cometcannon/tshirt-cannon-robot/doc/tikz-figures/kinematics.tex

\documentclass{standalone}
\usepackage{tikz}
\usepackage{standalone}

\newcommand{\AxisRotator}[1][rotate=0]{\tikz [x=0.25cm,y=0.60cm,line width=.2ex,-stealth,#1] \draw (0,0) arc (-150:150:1 and 1);}

\begin{document}
  \tikzstyle{robot} = [rectangle, minimum width=3cm, minimum height=4cm,text centered, draw=black]
  \tikzstyle{wheel} = [rectangle, minimum width=5mm, minimum height=1cm, draw=black]
  \tikzstyle{arrow} = [thick, ->, >=latex]
  \tikzstyle{dist} = [thick, <->, >=|]

  \begin{tikzpicture}
    \node (robot) [robot] {};
    \node (wheel 1) [wheel, left of=robot, xshift=-7.5mm, yshift=1cm] {0};
    \node (wheel 2) [wheel, right of=robot, xshift=7.5mm, yshift=1cm] {1};
    \node (wheel 3) [wheel, right of=robot, xshift=7.5mm, yshift=-1cm] {2};
    \node (wheel 4) [wheel, left of=robot, xshift=-7.5mm, yshift=-1cm] {3};

    \draw [arrow] (0,0) -- node[anchor=north, xshift=-4mm] {y} (-1,0);
    \draw [arrow] (0,0) -- node[anchor=west, yshift=5mm] {x} (0,1);
    \draw (0,0)  -- (0,0) node[xshift=2.8mm] {\AxisRotator[x=0.3cm,y=0.3cm,->,rotate=-90,black] $\omega_z$};
    \draw [dist] (0,2.3) -- node[anchor=south] {$l_1$} (1.8,2.3);
    \draw [dist] (0.03,2.3) -- node[anchor=south] {$l_1$} (-1.8,2.3);
    \draw [dist] (0,-2.3) -- node[anchor=north] {$l_1$} (1.8,-2.3);
    \draw [dist] (0.03,-2.3) -- node[anchor=north] {$l_1$} (-1.8,-2.3);
    \draw [dist] (2.3,0) -- node[anchor=west] {$l_2$} (2.3, 1);
    \draw [dist] (2.3,0.03) -- node[anchor=west] {$l_2$} (2.3, -1);
    \draw [dist] (-2.3,0) -- node[anchor=east] {$l_2$} (-2.3, 1);
    \draw [dist] (-2.3,0.03) -- node[anchor=east] {$l_2$} (-2.3, -1);
  \end{tikzpicture}
\end{document}
