cometcannon/tshirt-cannon-robot/doc/pics/wbs.pdf

5/9/2015 | Teleoperated Mobile Garment Accelerator
http://publish.smartsheet.com/b43ca22360854cf6b6d9cb59e5b9d781 | 1/2

## Teleoperated Mobile Garment Accelerator

| Tasks | Assigned to | Start | Finish
1 | Chassis
2 | Research chassis design | Hazen Eckert | 09/23/14 | 10/07/14
3 | Research suppliers and pricing | Hazen Eckert | 09/23/14 | 10/07/14
4 | Research mount designs | Omar Hasan | 09/23/14 | 10/07/14
5 | Chassis assembly | Omar Hasan | 11/05/14 | 11/15/14
6 | Chassis testing | Ryan Marcotte | 11/19/14 | 11/20/14
7 | Building mount | Ridhwaan Rahman | 02/06/15 | 03/31/15
8 | T shirt cannon
9 | Research solenoids | Hazen Eckert | 10/29/14 | 11/07/14
10 | Research tshirt cannons | Ridhwaan Rahman | 09/23/14 | 10/07/14
11 | Cannon testing | Hazen Eckert | 11/05/14 | 11/06/14
12 | Kill switch | Hazen Eckert | 11/11/14 | 12/12/14
13 | Cannon remote triggering | Hazen Eckert | 01/23/15 | 01/25/14
14 | Pneumatics | Hazen Eckert | 11/11/14 | 12/12/14
15 | Choosing a Hose | Hazen Eckert | 03/12/15 | 03/14/15
16 | Filling CO2 tank | Ridhwaan Rahman | 01/30/15 | 05/01/15
17 | Testing Electronic Charging/Firing | Hazen Eckert | 03/05/15 | 03/08/15
18 | Barrel support | Ridhwaan Rahman | 03/05/15 | 03/15/14
19 | Control Electronics
20 | Code for controlling wheels | Omar Hasan | 10/22/14 | 10/29/14
21 | Research on microcontrollers | Ryan Marcotte | 09/23/14 | 10/07/14
22 | Testing encoders/speed controllers | Omar Hasan | 11/19/14 | 02/03/15
23 | Implementing magic bytes | Omar Hasan | 02/13/15 | 02/20/15
24 | Power Distribution
25 | Procure battery | Omar Hasan | 10/22/14 | 10/29/14
26 | Research batteries, speed controllers | Omar Hasan | 09/23/14 | 10/15/14
27 | Research power conversion | Hazen Eckert | 10/22/14 | 10/29/14
28 | Power regulation, electronic triggering | Hazen Eckert | 02/13/15 | 03/13/15
29 | Wiring | Hazen Eckert | 02/27/15 | 03/05/15
30 | Protoboard | Hazen Eckert | 04/09/15 | 04/23/15
31 | User Interface
32 | Research camera | Ryan Marcotte | 10/22/14 | 10/29/14
33 | Research on networking | Ryan Marcotte | 09/23/14 | 10/07/14
34 | Set up build environment for Yun | Ryan Marcotte | 10/22/14 | 02/04/15
35 | Research camera streaming | Ridhwaan Rahman | 10/29/14 | 11/05/14
36 | Documentation/software planning | Ryan Marcotte | 11/05/14 | 04/23/15
37 | Video streaming | Ridhwaan Rahman | 11/05/14 | 11/19/14
38 | Writing Xbox controller module | Ryan Marcotte | 02/27/15 | 03/06/15

5/9/2015 | Teleoperated Mobile Garment Accelerator
http://publish.smartsheet.com/b43ca22360854cf6b6d9cb59e5b9d781 | 2/2

Collaboration (http://www.smartsheet.com/product-tour/collaboration?s=155) powered by Smartsheet

39 | Remote Control Feature | Ryan Marcotte | 03/12/15 | 03/19/15
40 | GUI | Ryan Marcotte | 04/23/15 | 04/27/15
41 | Miscellaneous
42 | Ethics Report | Ridhwaan Rahman | 10/22/14 | 10/24/14
43 | Learning git | Ridhwaan Rahman | 10/29/14 | 01/23/15
44 | Poster | Ridhwaan Rahman | 11/19/14 | 11/26/14
45 | Debugging Atheros boot sequence | Omar Hasan | 02/19/15 | 02/26/15
46 | Debugging Atheros to AVR serial connection | Ryan Marcotte | 02/19/15 | 02/26/15
47 | Ethics Report | Ridhwaan Rahman | 03/12/15 | 03/19/15
48 | Max speed testing | Ryan Marcotte | 04/09/15 | 04/11/15
49 | Max speed testing | Omar Hasan | 04/09/15 | 04/11/15
