cometcannon/tshirt-cannon-robot/doc/pics/electronics/protoboard.jpg

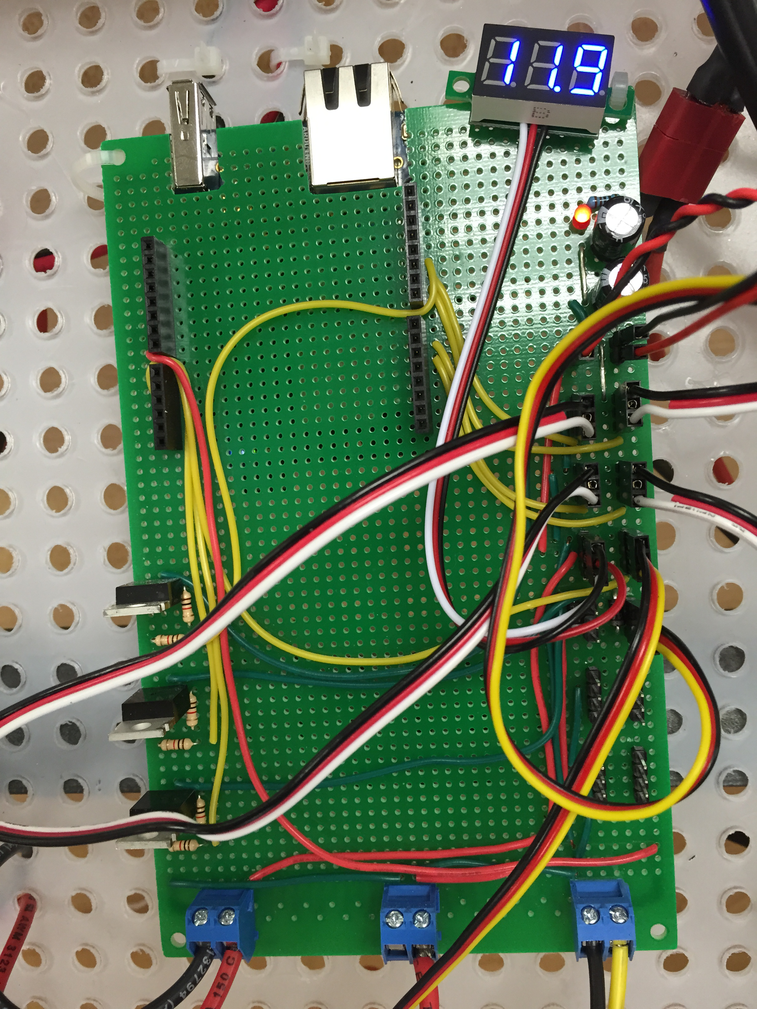
doc/pics/electronics/protoboard.jpg
