cometcannon/tshirt-cannon-robot/doc/pics/s1.pdf

# Teleoperated Mobile Garment Accelerator

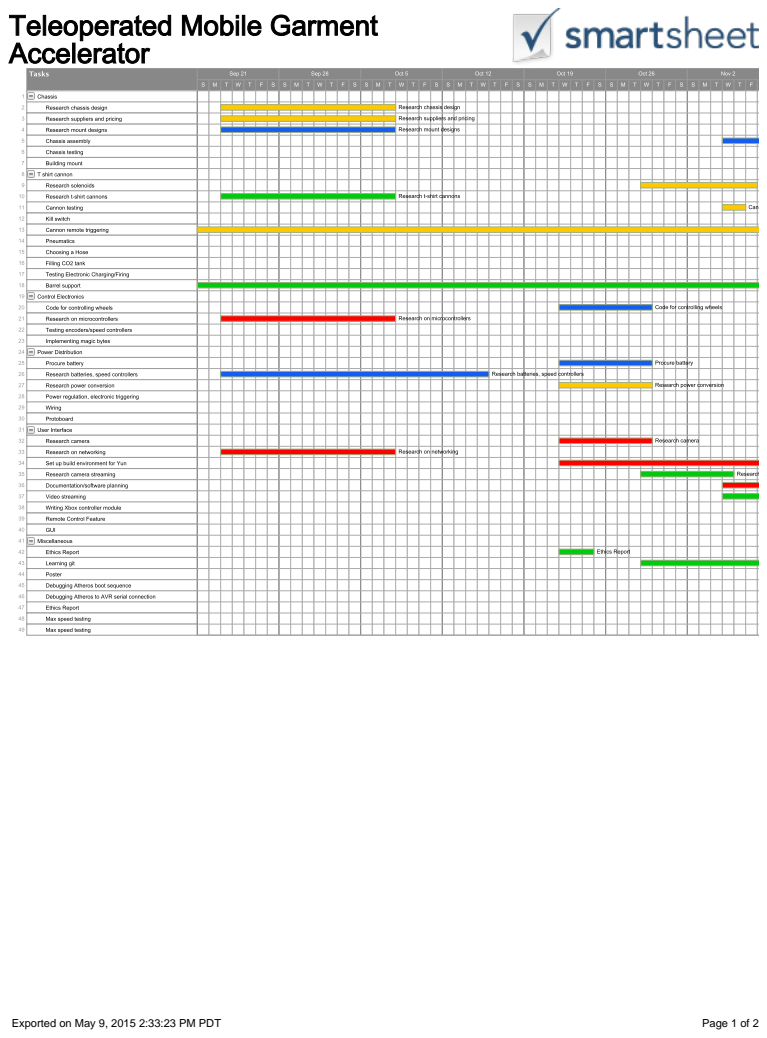
[picture p9: page 1]
Exported on May 9, 2015 2:33:23 PM PDT; Page 1 of

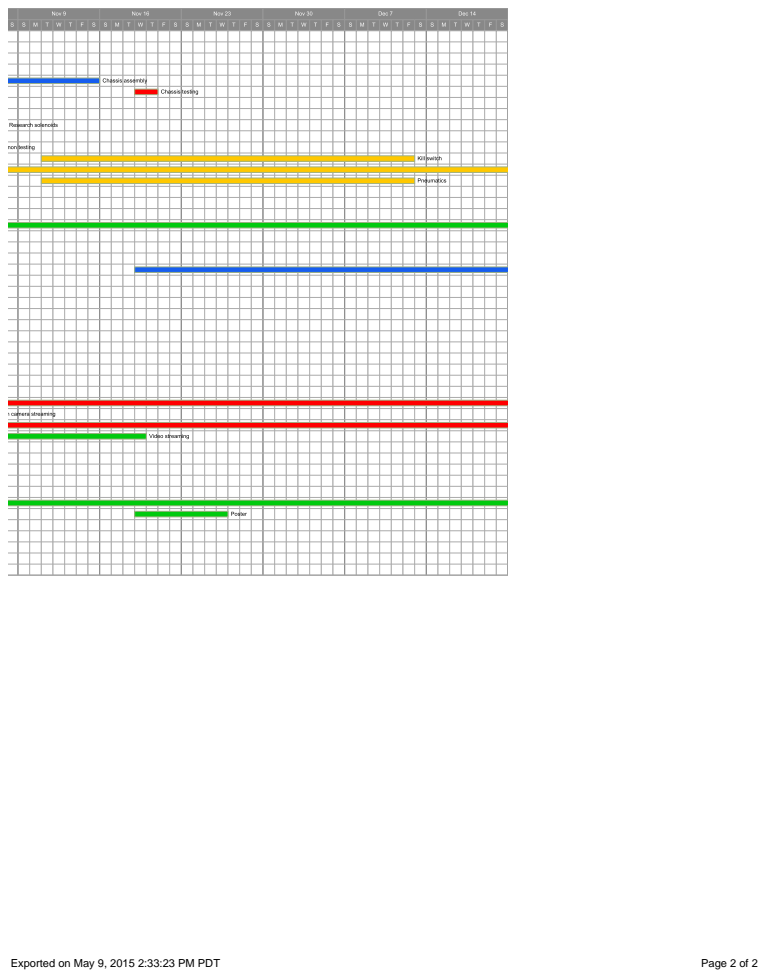
[picture p10: page 2]
Exported on May 9, 2015 2:33:23 PM PDT; Page 2 of
