cometcannon/tshirt-cannon-robot/doc/pics/s2.pdf

# Teleoperated Mobile Garment Accelerator

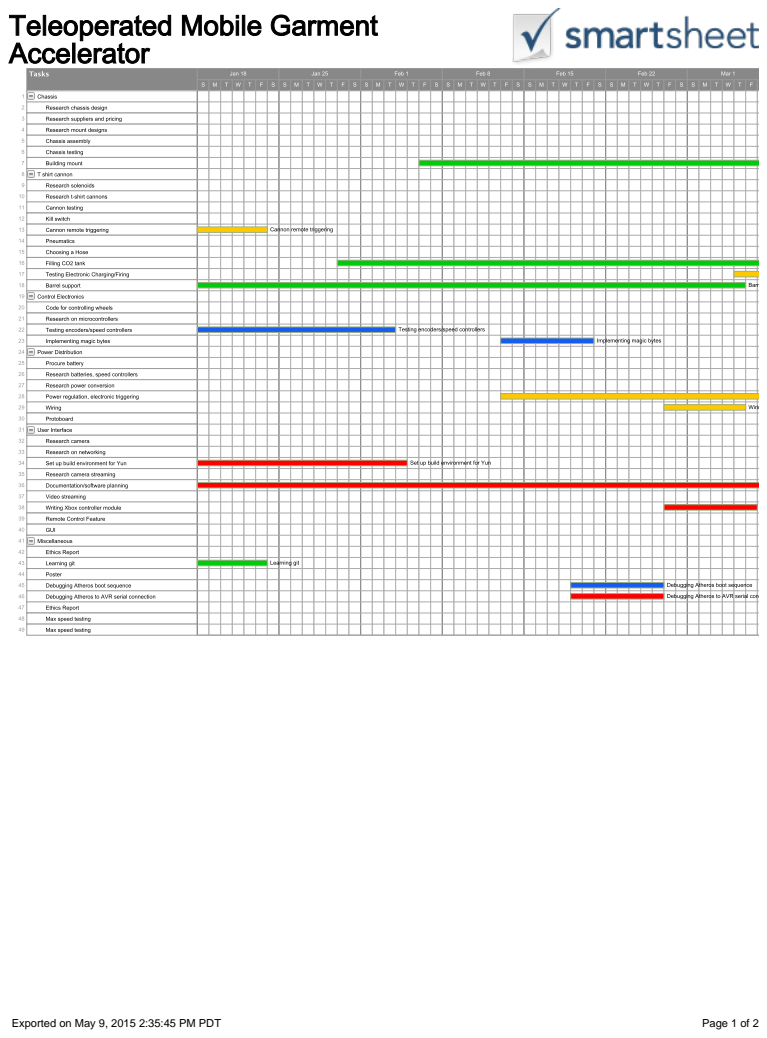
[picture p11: page 1]
Exported on May 9, 2015 2:35:45 PM PDT; Page 1 of

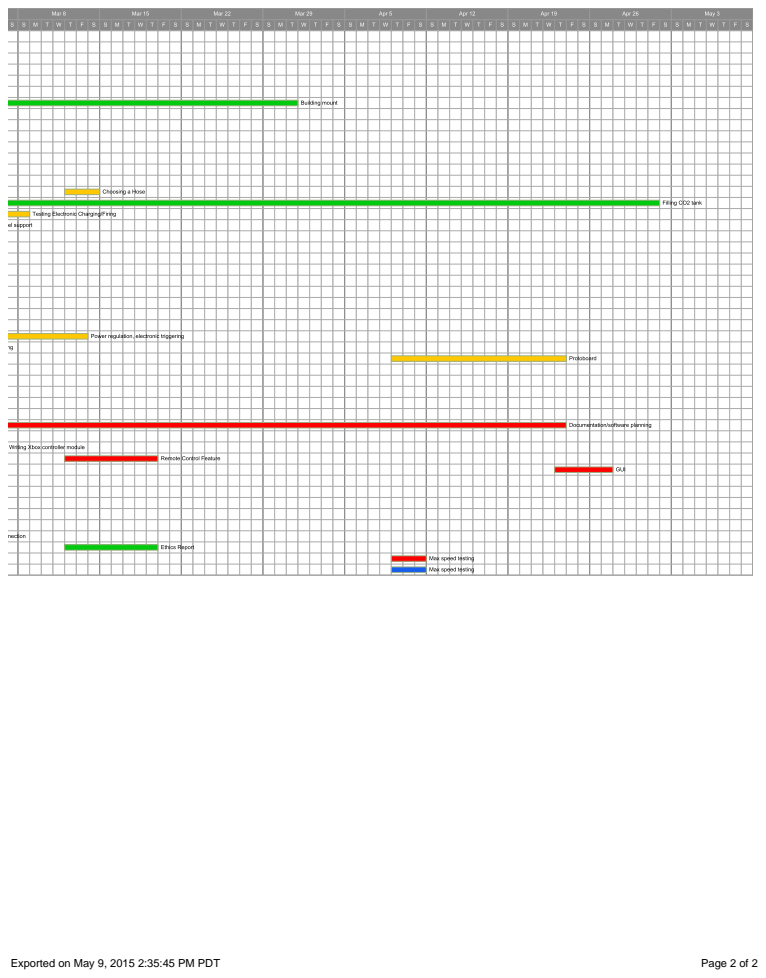
[picture p12: page 2]
Exported on May 9, 2015 2:35:45 PM PDT; Page 2 of
