cometcannon/tshirt-cannon-robot/src/AVR/test/wheel_test/wheel.h

#ifndef Wheel_h
#define Wheel_h

#include <Arduino.h>
#include <Servo.h>
#include "PID_controller.h"
#include "encoder.h"

/* Constants */
#define WHEEL_DIAMETER              0.1524 //Meters
#define GEAR_RATIO                  12.75

class Wheel
{     
public:
    Wheel();
    explicit Wheel(int _ESCPin, Servo* _esc, Encoder* _encoder, PIDController* _angularVelocityController);
    int ReturnThrottle();
    void SetThrottle(float throttle);
    void ControlAngularVelocity(float angularVelocitySetpoint);
    
    char ESCPin;
    int currentThrottle;
    
private:
    Encoder* encoder;
    PIDController* angularVelocityController;
    Servo* esc;
};

#endif
