cometcannon/tshirt-cannon-robot/(commit log)

2014-10-21 Added Eigen Libraries as well as initial src code for arduinosq
2014-11-03 add velocity command message format to documentation
2014-11-05 Added sections about cannon and chassis
2014-11-09 add velocity kinematics explanation
2014-11-09 Added a test for controller the motor with the ESC
2014-11-10 add calls to velocity command function
2014-11-10 Modified wheel_test to test whether Servo.h is working correctly
    [wheel_test.ino]
2014-11-11 add socket functionality to simple ui
2014-11-11 add atheros interface for doing velocity kinematics
2014-11-12 add capability to command individual motors
2014-11-12 add ability to command motors with stubs for bridge communication
2014-11-12 Modified wheel_test.ino to recieve velocity commands from atheros
2014-11-14 Added commented out sections to compare my Wheel Class with simpler, working code
2014-11-15 Corrected Encoder testing
2014-11-20 correct wheel numbering
2014-11-20 Added functionality for reading in the wheel velocity command from the Atheros chip
2015-02-05 get the inverse kinematics calculations working
2015-02-10 fix velocity kinematics and update message formats
2015-02-12 Modified testing for angular velocity control
2015-02-12 simple socket connection
2015-02-17 Added backup source code that will allow access to the atheros chip through the usb port (in case the openwrt needs to be booted in safe mode
2015-02-26 Added functionality for cannon trigger and pressure regulation
2015-02-26 Added pressure regulation command to overview
2015-02-26 Added functionality for commanding wheel velocities and documented them
2015-03-03 don't start the keep alive thread for now
2015-03-04 use separate mutexes in atherosd and give run-time enabling of the keep-alive threads
2015-03-05 implemented fire and set pressure commands
2015-03-06 Fixed Serial read bug
    [test.ino]
2015-03-06 Fixed command motors bug
    [test.ino]
2015-03-12 Robot wont send same wheel commands twice in a row
2015-03-14 Added debug mode to read angular velocity
2015-03-15 Removed Eigen Libs and updated wheel velocity functionality
2015-04-03 Fixed crashing socket connection when java app disconnects
    [atherosd.c]
2015-04-03 Removed KeepAlive thread from RobotManager startup. Added Controller disconnection detection by modifying lwjgl jar and Remote Controller. Added streaming video command to README
2015-04-03 get rid of all of the raspberry pi stuff
2015-04-05 Added link for xbox360 controller drivers for mac
2015-04-05 test.ino can now send pressure and angular velocity information
2015-04-05 Added new commands. Replaced SetPressureCommand with IncreasePressureCommand.
    [DebugPanel.java, MotorVelocityCommand.java]
2015-04-05 Added sending pressure and wheel velocities commands to app
2015-04-05 Added a thread for sending pressure commands for reporting the amount of pressure in the tank.
2015-04-13 add configuration file for Yun's network configuration
    This file can be copied and pasted into the Yun's terminal to configure
    it. It sets up a wireless network with the Yun serving as the access
    point. Additionally, it forms a bridge connection between the wireless
    interface (connection to the computer) and the wired
    interface (connection to the Pi)
2015-04-20 add stubs for pressure, velocity, and status panels
2015-04-20 draw the robot using proportions relative to the size of the frame
2015-04-21 Made some small fixes to compensate for wiring changes
    [atherosd.c, test.ino]
2015-04-21 replaced deprecated motor command with honking
    [atherosd.c]
2015-04-21 add velocity visualization and some touch ups to the GUI
2015-04-21 small refactoring of velocity variable placement
2015-04-22 Removed a print statement for debugging honking
2015-04-22 Refactored AVR code and added auto charging of cannon when tank is below 80 psi
2015-04-24 Changed min pressure
2015-04-26 Chose better naming conventions and removed deprecated encoder-test
